Ezetowers/tp-lm-autito/Informe/Portada.tex

\author{} % Lo pongo para que el warning no moleste :p
\setlength{\unitlength}{1cm} %  Especifica la unidad de trabajo
\thispagestyle{empty}

\begin{picture}(18,0)
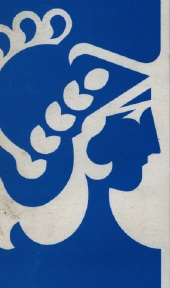
[picture p14: Informe/Imagenes/Logo1.png]
\put(0,0){}

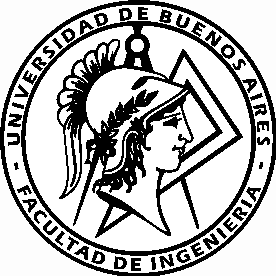
[picture p15: Informe/Imagenes/Logo2.png]
\put(10.5,0){}

\end{picture}
\\[1.5cm]
\begin{center}
	\textbf{{\Huge Facultad de Ingenier\'ia \\ Universidad de Buenos Aires}}\\[2cm]
	{66.09 Laboratorio de Microcomputadoras}\\[0.5cm]
	{Informe}\\[2.5cm]
\end{center}

\begin{flushleft}
	\textbf{Integrantes:} \\[1cm]

	\begin{tabular}{|c|c|c|}
		\hline
		\textbf{\normalsize Padr\'on} & \textbf{\normalsize Nombre} & \textbf{\normalsize Email} \\
		\hline
		\normalsize 89579 & \normalsize Torres Feyuk, Nicol\'as R. Ezequiel & \normalsize ezequiel.torresfeyuk@gmail.com \\
		\hline
		\normalsize 90406 & \normalsize Levi Hadid, Lucas Alberto & \normalsize lucaslh9@hotmail.com \\
		\hline
	\end{tabular}
\end{flushleft}
\date{} % Hace que no se imprima la fecha en la cual se compilo el .tex
