Ezetowers/tp-lm-autito/Anteproyecto/TP1.pdf

# Facultad de Ingenier´ıa Universidad de Buenos Aires

# 66.09 Laboratorio de Microcomputadoras

# Anteproyecto

# Integrantes:

Padr´on | Nombre | Email
89579 | Torres Feyuk, Nicol´as R. Ezequiel | ezequiel.torresfeyuk@gmail.com
90406 | Levi Hadid, Lucas Alberto | lucaslh9@hotmail.com

1

Facultad de Ingenier´ıa − Universidad de Buenos Aires
66.09 Laboratorio de Microcomputadoras | 2

## ´Indice

1. Funcionalidades | 3

Anteproyecto
Integrantes: Torres Feyuk, Levi Hadid

Facultad de Ingenier´ıa − Universidad de Buenos Aires
66.09 Laboratorio de Microcomputadoras | 3

## 1. Funcionalidades

### 1.1. Control Remoto

Display indicador de velocidad del auto

Motor er´otico (te hace vibrar)

Alarma de aviso de autodestrucci´on

Medidor estado del auto

Recepci´on de datos del auto a trav´es del receptor (Comunicaci´on Serie)

### 1.2. Autito

Control de los Motores (mediante dos puerto H)

Env´ıo de datos de los bumpers al micro (los bumpers deben ser doble llave)

Env´ıo de datos del micro al emisor (Comunicaci´on Serie)

Anteproyecto
Integrantes: Torres Feyuk, Levi Hadid
