Ezetowers/tp-lm-autito/Anteproyecto/Imagenes/DiagramaControl.pdf

XTAL2 18

XTAL1 19

ALE 30
EA 31

PSEN 29

RST

9

P0.0/AD0 | 39
P0.1/AD1 | 38
P0.2/AD2 | 37
P0.3/AD3 | 36
P0.4/AD4 | 35
P0.5/AD5 | 34
P0.6/AD6 | 33
P0.7/AD7 | 32

P1.0/T2

1
P1.1/T2EX

2

P1.2

3
P1.3

4

P1.4

5
P1.5

6
P1.6

7

P1.7

8

P3.0/RXD | 10
P3.1/TXD | 11
P3.2/INT0 | 12
P3.3/INT1 | 13
P3.4/T0 | 14
P3.7/RD | 17
P3.6/WR | 16
P3.5/T1 | 15
P2.7/A15 | 28
P2.0/A8 | 21
P2.1/A9 | 22
P2.2/A10 | 23
P2.3/A11 | 24
P2.4/A12 | 25
P2.5/A13 | 26
P2.6/A14 | 27

U1

AT89C52

Emisor - Receptor

Motor Vibrador

Display 7-segm

Comandos

Velocidades
