Ezetowers/tp-lm-autito/Informe/Imagenes/EsquematicoAuto.PDF

U3

C3

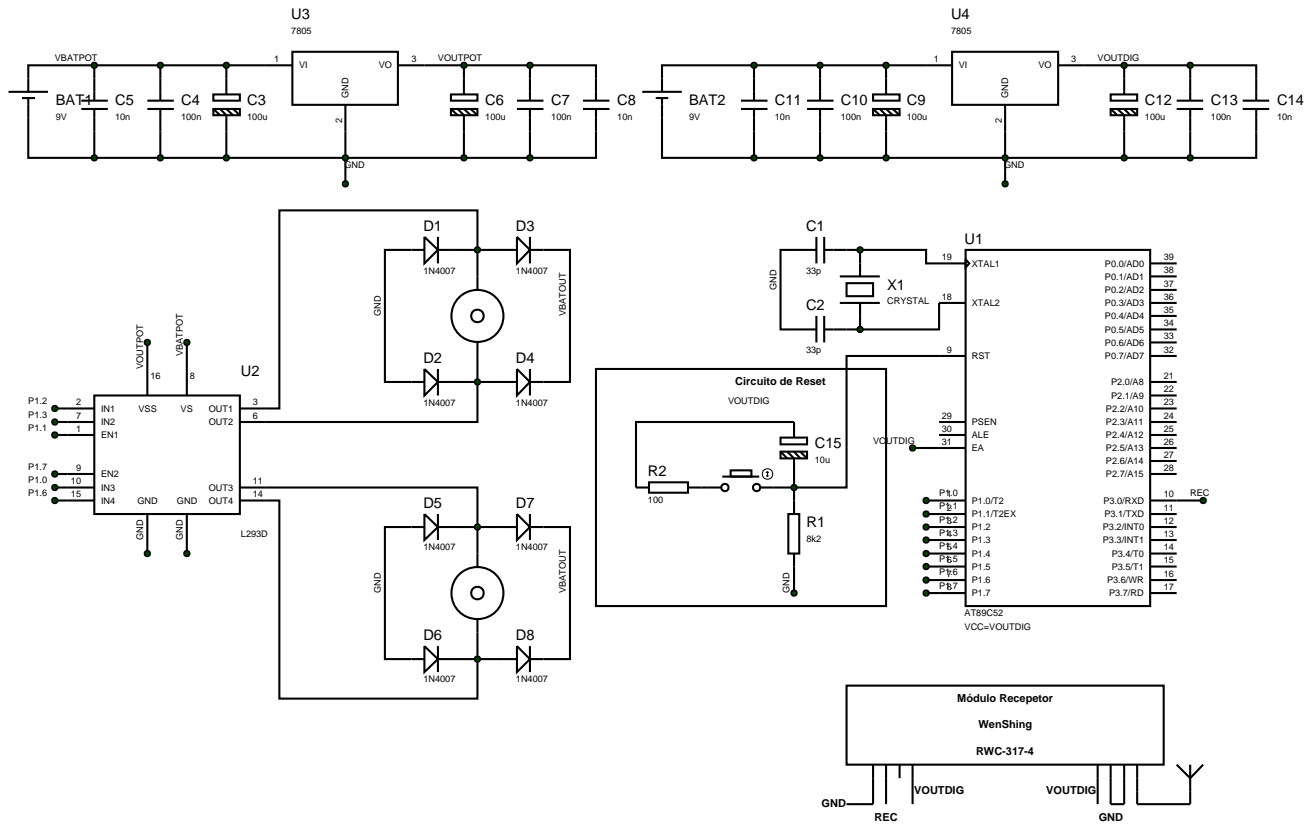
[picture p24: page 1]
