Ezetowers/tp-lm-autito/Informe/Imagenes/EsquematicoControl.PDF

U2
R1

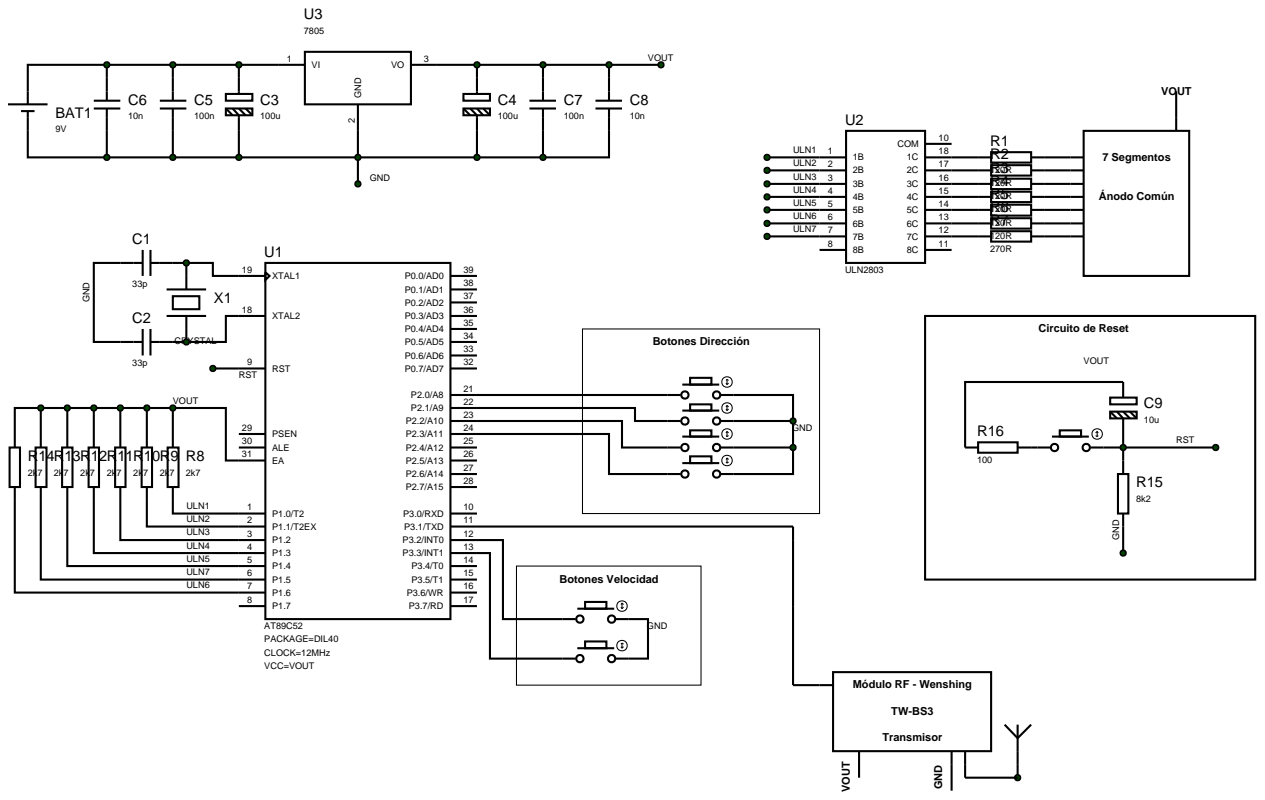
[picture p25: page 1]
