Ezetowers/tp-lm-autito/(list of files, drawings)

Other design files:
Esquematicos/EsquematicoAuto.DSN
Esquematicos/EsquematicoControl.DSN
Esquematicos/SimulaciónProyecto.DSN
