Ezetowers/tp-lm-autito/(commit log)

2012-04-26 Subo la estructura del proyecto, y un par de archivos del Anteproyecto.
2012-05-09 Subo el diagrama del autito
2012-05-10 Mando la versión terminada del AnteProyecto. Le faltan cosas, pero fué
2012-05-10 Agrego unas cosas que faltaron
2012-06-21 Agrego el cuerpo del Informe
2012-06-21 Subo el soft y los esquemáticos (archivos del Proteus) del autito y el control
    [diseñoAutito.DSN, diseñoControl.DSN]
2012-06-23 Subo el código con el agregado de la sincronización y los esquemáticos (aún no terminados del proyecto)
    [diseñoAutito.DSN, diseñoControl.DSN]
2012-06-23 Subo los esquemáticos, no los pude subir en al rev. anterior
    [EsquemáticoAuto.DSN, EsquemáticoControl.DSN, SimulaciónProyecto.DSN]
2012-06-24 Subo una cosita más a la estructura del informe
2012-06-24 Subo un par de cambios más de estructura del proyecto
    [EsquematicoAuto.DSN, EsquematicoControl.DSN, EsquemáticoAuto.DSN]
2012-06-24 Subo el diagrama eb bloque del control y su correspondiente modificacion en el informe
2012-06-27 Subo el Informe hasta ahora. Falta menos...
2012-06-27 Subo el código en su última versión
2012-06-29 Subo el informe que entregamos en la entrega del 28/06/12. Faltan los .dia, los subo en otro momento porque ahora estoy cansado ^^
2012-07-04 Subo algunas modificaciones del Informe. Falta inicializar los stack pointers y corregir el antirebote.
2012-07-05 Subo la última versión del TP que tengo que debería ser la HEAD
2012-07-05 Subo más modificaciones al TP. Ya arreglé los softs antirebotes. Faltaría rehacer el diagrama de flujo del mismo. Subí también los código actualizados, tanto en el Informe como los .asm
2012-07-05 Subo la inicialización del stack pointer que me había olvidado. Sigue faltando el diagrama de flujo nuevo de los botones de velocidades con el antirebote
2012-07-05 Subo los diagramas de flujo modificados
2012-07-12 Subo últimas modificaciones. Agrego fotos del autito y cambio lo del sp de 8 a 7
